medo64/Cananka/Hardware/Board/Cananka [D].md

### Cananka USB ###

Board size: 105.8 x 26.0 mm ~ 4.3 sqin
Panel size: 29.5 x 20.3 mm ~ 1.0 sqin (2x)

#### Input ####

Voltage: 5 V ±10%
Current: 100 mA

#### Parts ####

|  # | Part | RefDes  | Preferred Part Number | Alternate Part Number |
|---:|---|---|---|---|
|  2 | C 22pF NP0 16V (0805) | C1 C2 | 399-8036-1-ND | |
|  4 | C 100nF X7R 16V (0805) | C3-C6 | 478-5311-1-ND | |
|  1 | C 330nF X7R 16V (0805) | C7 | 732-7669-1-ND | |
|  3 | C 10uF X5R 16V (0805) | C8-C10  | 1276-1096-1-ND | |
|  1 | D TVS 150W Zenner CAN (SOT23-3) | D1 | 497-13262-1-ND | 568-4032-1-ND |
|  1 | DS LED RGB CA (1204) | DS1 | 160-2234-1-ND | |
|  5 | DS LED (0805) | DS2-DS6 | 475-1415-1-ND | |
|  1 | J USB B, horizontal | J1 | ED2982-ND | |
|  1 | J MC 1,5/ 4-G-3,81 | J2 | ED2810-ND | 277-1208-ND |
|  1 | L Ferrite 40Ohm (0805) | L1 | 445-2201-1-ND | |
|  4 | R 120 0.125W (0805) | R1-R4 | 311-120CRCT-ND | |
|  4 | R 330 0.125W (0805) | R5-R8 | RMCF0805FT330RCT-ND | CR0805-FX-3300GLFCT-ND |
|  7 | R 1K 0.125W (0805) | R9-R15  | RMCF0805FT1K00CT-ND | 311-1.00KCRCT-ND |
|  1 | U MCP2221A (TSSOP-14) | U1 | MCP2221A-I/ST-ND | |
|  1 | U PIC18F25K80 (SSOP-28) | U2 | PIC18F25K80-I/SS-ND | |
|  1 | U ISO1050 (SOP-8) | U3 | 296-24818-1-ND | |
|  1 | VR DC-DC 5V->5V 1W (SIP-4) | VR1 | 945-1655-5-ND | |
|  1 | Y Crystal 12MHz 50ppm 20pF | Y1 | 887-2011-ND | 887-1238-ND |
|  1 | H Enclosure 1593DBK | | HM861-ND | |
|  4 | H PCB Screw Self-tapping M3 6mm (#4 1/4") | | 36-9191-3-ND | SR6004-ND |
|  2 | P MC 1,5/ 4-ST-3,81 | | ED2877-ND | 277-1163-ND |

#### UART Configuration ####

In order to configure the device, one has to use MCP2221 Utility application
(download from Microchip). Device works with factory configuration but the
following changes are suggested:

    * Descriptor: Cananka
    * Manufacturer: Josip Medved
    * Enumerate with serial number: Yes

All other settings should remain default.
