medo64/Cananka/USB/Hardware-mini/Board/Cananka USBmini [D].md

### Cananka USB/mini ###

Board size: 54.0 x 16.5 mm ~ 1.4 sqin

#### Input ####

Voltage: 5 V ±10%
Current: 500 mA

#### Parts ####

|  # | Part | RefDes  | Preferred Part Number | Alternate Part Number |
|---:|---|---|---|---|
|  3 | C 100nF X7R 16V (0805) | C1-C3 | 478-5311-1-ND | |
|  1 | C 330nF X7R 16V (0805) | C4 | 732-7669-1-ND | |
|  2 | C 10uF X5R 16V (0805) | C5-C6 | 1276-1096-1-ND | |
|  1 | D Shottky 30V LowVf {SDM100K30L} (SOD323) | D1 | SDM100K30LDIDKR-ND | BAS3010A03WE6327HTSA1CT-ND |
|  6 | DS LED (0805) | DS1-DS6 | 475-1415-1-ND | |
|  1 | J MC 1,5/ 4-G-3,81 | J2 | ED2810-ND | 277-1208-ND |
|  1 | L Ferrite 40Ohm (0805) | L1 | 445-2201-1-ND | |
|  1 | P USB A, plug, horizontal | P1 | WM3983CT-ND | WM17118-ND |
|  2 | Q P-MOSFET 20V LowVgs {DMG2305UX} | Q1 Q2 | DMG2305UX-13DICT-ND | |
|  4 | R 120 0.125W (0805) | R1-R4 | 311-120CRCT-ND | |
|  3 | R 330 0.125W (0805) | R5-R7 | RMCF0805FT330RCT-ND | CR0805-FX-3300GLFCT-ND |
|  6 | R 1K 0.125W (0805) | R8-R13  | RMCF0805FT1K00CT-ND | 311-1.00KCRCT-ND |
|  1 | U MCP2221A (TSSOP-14) | U1 | MCP2221A-I/ST-ND | |
|  1 | U PIC18F25K80 (SSOP-28) | U2 | PIC18F25K80-I/SS-ND | |
|  1 | U MCP2561 (SOIC-8) | U3 | MCP2561-E/SN-ND | 568-10289-1-ND |
|  1 | P MC 1,5/ 4-ST-3,81 | | ED2877-ND | 277-1163-ND |

1/2" heat-shrink tubing, 50mm

WARNING: This is a non-isolated board - beware of ground loops and all the fun
that can happen with different ground potentials.

#### UART Configuration ####

In order to configure the device, one has to use MCP2221 Utility application
(download from Microchip). In configuration, one MUST perform the following
changes:

    * GP1: 1 (CLK_OUT)

The following changes are suggested:

    * Required Current: 500 mA
    * Descriptor: Cananka
    * Manufacturer: Josip Medved
    * Enumerate with serial number: Yes

All other settings should remain default.
