medo64/Cananka/Hardware/Board/Cananka [D] Configuration.png

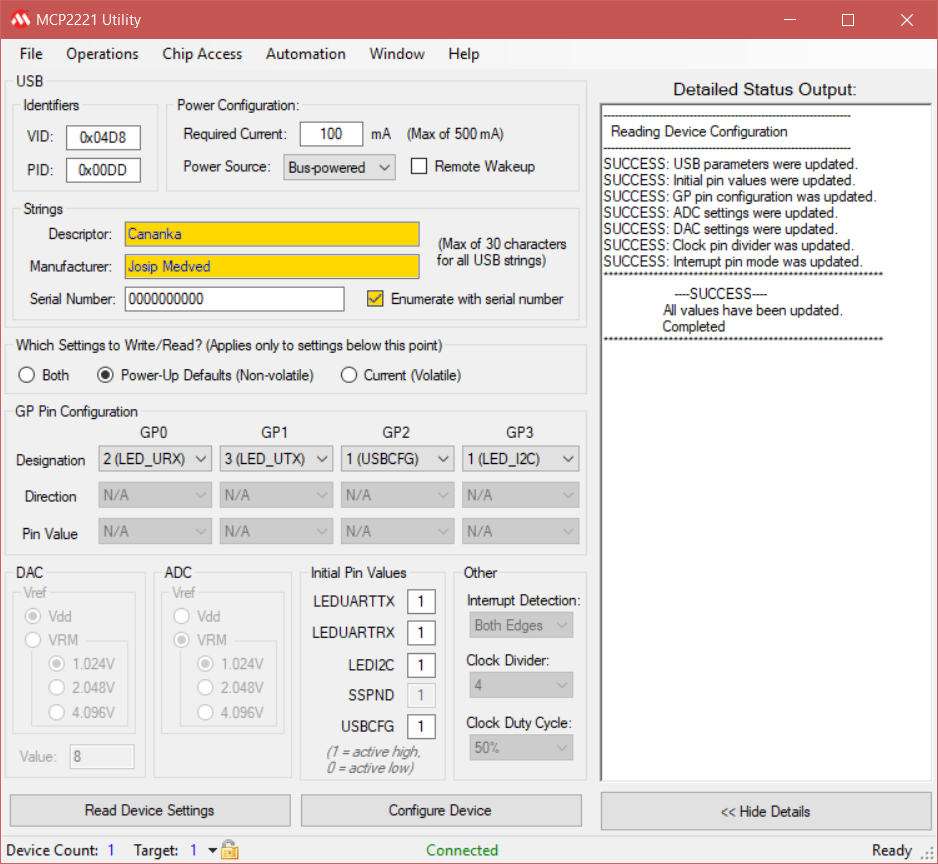
Hardware/Board/Cananka [D] Configuration.png
