medo64/Cananka/SCHEMATICS-RJ45.pdf

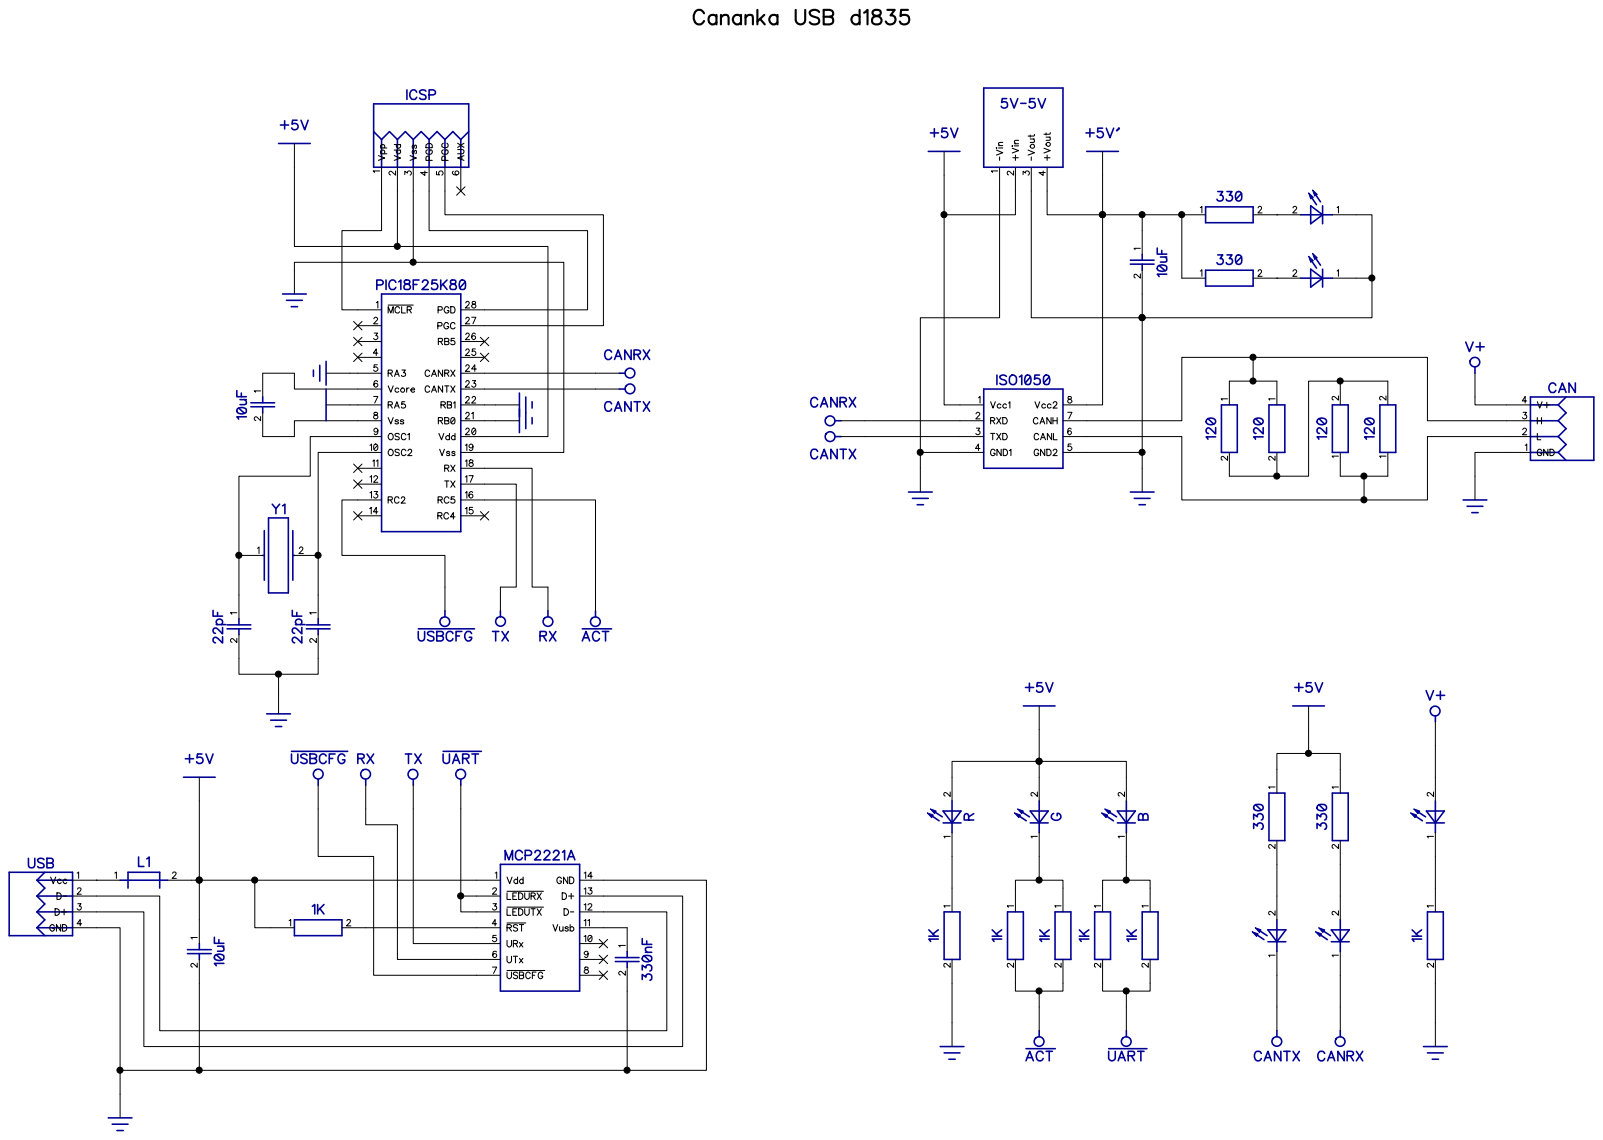
[picture p2: page 1]
