medo64/Cananka/(list of files, drawings)

Other design files:
Hardware/Board/Cananka [D] Panel Back.dip
Hardware/Board/Cananka [D] Panel Front.dip
Hardware/Board/Cananka [D].dch
Hardware/Board/Cananka [D].dip
Hardware/Board/RJ45/Cananka RJ45 [D] Panel Back.dip
Hardware/Board/RJ45/Cananka RJ45 [D] Panel Front.dip
Hardware/Board/RJ45/Cananka RJ45 [D].dip
