medo64/Cananka/(commit log)

2016-05-09 Initial version.
    [Cananka [A].dip]
2016-05-13 Corrected components.
    [Cananka [A].dip]
2016-05-15 Updated board to fit official case.
    [Cananka [A].dip, Cananka [B].dip]
2016-05-15 Refactoring LEDs and adding test points.
    [Cananka [B].dip]
2016-05-15 Moved CAN connector descriptions.
    [Cananka [B].dip]
2016-05-15 Added forgotten RESET pullup.
    [Cananka [B].dip]
2016-05-15 Added silk screen for SPI.
    [Cananka [B].dip]
2016-05-15 Moved fuse to top layer.
    [Cananka [B].dip]
2016-05-16 Adjusted silk screen.
    [Cananka [B].dip]
2016-05-26 Increasing hole size for 12V->5V VR.
    [Cananka [B].dip]
2016-05-26 Swapped VR2 pinout to correct one.
    [Cananka [B].dip, Cananka [C].dip]
2016-05-26 Refactoring write-protect to use positive logic.
    [Cananka [C].dip]
2016-05-26 Refactoring LED placement.
    [Cananka [C].dip]
2016-05-27 Refactoring layout.
    [Cananka [C].dip]
2016-05-27 Moving Ext LED source to after fuse.
    [Cananka [C].dip]
2016-05-27 Refactoring flood-fill.
    [Cananka [C].dip]
2016-06-13 Updating silkscreen and instructions.
    [Cananka [C].dip]
2016-06-13 Fixed bug with remote on/off.
    [Cananka [C].dip, Cananka [D].dip]
2016-08-22 Moving WP wires a bit away.
    [Cananka [D].dip]
2017-05-28 Changed bear icon.
    [Cananka [D].dip]
2017-06-03 Adjusted icon.
    [Cananka [D].dip]
2018-07-08 Moving HAT to a separate directory.
    [Cananka HAT [D].dip, Cananka [D].dip]
2018-07-09 Added CanStick to USB, USBmini, and USB-RJ45 directories.
    [CanBusSpeed.xlsx, Cananka USB [B] Panel Back.dip, Cananka USB [B] Panel Front.dip, Cananka USB [B].dip, Cananka USB-RJ45 [B] Panel Back.dip, Cananka USB-RJ45 [B] Panel Front.dip, Cananka USB-RJ45 [B].dip, Cananka USBmini [C].dip]
2018-07-14 Added termination control and status LED.
    [Cananka USB [B] Panel Back.dip, Cananka USB [B].dip, Cananka USB [C] Panel Back.dip, Cananka USB [C] Panel Front.dip, Cananka USB [C].dip, Cananka USB-RJ45 [B] Panel Back.dip, Cananka USB-RJ45 [B].dip, Cananka USB-RJ45 [C] Panel Back.dip]
2018-08-16 Added screw description.
2018-08-16 Update ICSP connector to be more frendly to pogo pins.
    [Cananka USB [C].dip, Cananka USB-RJ45 [C].dip, Cananka USBmini [C].dip]
2018-08-16 Added RGB LED anode marking.
    [Cananka USB [C].dip, Cananka USB-RJ45 [C].dip]
2018-08-17 Adding current limiting resistor to optocoupler.
    [Cananka USB [C].dip, Cananka USB-RJ45 [C].dip]
2018-08-17 Removing resistor array to minimize component count.
    [Cananka USB [C].dip, Cananka USB-RJ45 [C].dip]
2018-08-17 Changed MOSFET to a low Vgs one.
    [Cananka USB [C].dip, Cananka USBmini [C].dip]
2018-08-17 Swaping 10K resistor for 1K to reduce component count at the cost of current.
    [Cananka USB [C].dip, Cananka USB-RJ45 [C].dip]
2018-08-17 Removed controllable termination as it downgrades CAN bus resiliency to transients.
    [Cananka USB [C].dip, Cananka USB-RJ45 [C].dip]
2018-08-17 Updated USBmini to use MCP2221A instead of MCP2221.
    [Cananka USBmini [C].dip]
2018-08-17 Swapping FT232RL for MCP2221A.
    [Cananka USB [C].dip, Cananka USB-RJ45 [C].dip]
2018-08-17 Minor refactorings.
    [Cananka USBmini [C].dip]
2018-08-17 Replaced diode for an equivalent one.
    [Cananka USBmini [C].dip]
2018-08-17 Added UART configuration description.
2018-08-17 Refactoring board to lower component count.
    [Cananka USBmini [C].dip]
2018-08-17 Sorting out components for easier availability.
    [Cananka USB [C].dip, Cananka USB-RJ45 [C].dip, Cananka USBmini [C].dip]
2018-08-18 Expanded choice of TVS diode.
    [Cananka USB [C].dip, Cananka USB-RJ45 [C].dip]
2018-08-18 Clock isn't sent out on non-FTDI devices.
    [Cananka USB [C].dip, Cananka USB-RJ45 [C].dip]
2018-08-21 TVS diodes a bit closer to the pins.
    [Cananka USB [C].dip, Cananka USB-RJ45 [C].dip]
2018-08-21 Swapped resistor and LED (Active) so all LEDs are pulled the same way.
    [Cananka USBmini [C].dip]
2018-08-21 Added USBmini schematics.
    [Cananka USBmini [C].dch]
2018-08-21 Rotating LED to point the same way as the other.
    [Cananka USB [C].dip, Cananka USB-RJ45 [C].dip]
2018-08-22 Added schematics for USB.
    [Cananka USB [C].dch, Cananka USB [C].dip, Cananka USB-RJ45 [C].dip, Cananka USBmini [C].dch]
2018-08-22 Fixing copper pour on USB/mini.
    [Cananka USBmini [C].dip]
2018-08-25 Corrected revision file naming.
    [Cananka USB [C].dip, Cananka USB [D] Panel Back.dip, Cananka USB [D] Panel Front.dip, Cananka USB [D].dch, Cananka USB [D].dip, Cananka USB-RJ45 [C].dip, Cananka USB-RJ45 [D] Panel Back.dip, Cananka USB-RJ45 [D] Panel Front.dip]
2018-08-25 Added extra details for pin configuration.
2018-08-27 Changed USBmini connector to a horizontal one.
    [Cananka USBmini [D].dip]
2018-08-27 Reorganizing silk screen a bit.
    [Cananka USBmini [D].dip]
2018-09-02 Placing another resistor on blue LED channel.
    [Cananka USB [D].dch, Cananka USB [D].dip, Cananka USB-RJ45 [D].dip]
2018-09-03 Refactoring device versioning.
    [Cananka USB [D].dip, Cananka USB-RJ45 [D].dip, Cananka USBmini [D].dip]
2018-09-03 Connecting USBCFG to RC2.
    [Cananka USB [D].dch, Cananka USB [D].dip, Cananka USB-RJ45 [D].dip, Cananka USBmini [D].dch, Cananka USBmini [D].dip]
2018-09-03 Load is stopped once CAN bus is closed.
2018-09-03 Refactoring versioning.
    [Cananka USB [D].dip, Cananka USB-RJ45 [D].dip]
2018-09-03 Expanding versioning a bit.
    [Cananka USBmini [D].dip]
2018-09-03 Updated schematics.
2018-09-04 Added metric screw DigiKey code.
2018-09-16 Moved ground a bit.
    [Cananka USB [D].dip, Cananka USB-RJ45 [D].dip]
2018-09-17 Corrected capacitor count.
2018-09-17 Swapped 22pF capacitors to 0805.
    [Cananka USB [D].dip, Cananka USB-RJ45 [D].dip]
2018-09-18 Renamed UartBuffer to CommandBuffer.
2018-09-18 Reworked UART receive to use interrupts.
2018-09-21 Removed support for MCP2562 from USB/mini.
    [Cananka USBmini [D].dip]
2018-09-21 Made USB/mini board smaller to match CAN connector size.
    [Cananka USBmini [D].dip]
2018-09-21 Reorientating LEDs.
    [Cananka USBmini [D].dip]
2018-09-21 Merged schematics update.
    [Cananka USBmini [D].dch]
2018-10-29 Updated LED count.
2018-10-29 Reorganizing directory structure a bit.
    [Cananka USB-RJ45 [D] Panel Back.dip, Cananka USB-RJ45 [D] Panel Front.dip, Cananka USB-RJ45 [D].dip, Cananka USBmini [D].dch, Cananka USBmini [D].dip]
2018-10-29 Moving version silkscreen to top.
    [Cananka USB [D].dip, Cananka USB-RJ45 [D].dip]
2018-10-29 Updated version silkscreen.
    [Cananka USBmini [D].dip]
2018-10-29 Option to save CAN bus settings for the next boot.
2021-10-03 Added new board sized as framework module (not tested)
    [Cananka USBframework [D] Tongue.dip, Cananka USBframework [D].dip]
2021-10-03 Minor refactoring
    [Cananka USBframework [D].dip]
2021-10-09 Separate pinout for Cananka/framework
    [Cananka USBframework [D].dip]
2021-11-23 Splintered HAT into a separate repository
    [CanBusSpeed.xlsx, Cananka Framework [D] Tongue.dip, Cananka Framework [D].dip, Cananka HAT [D].dip, Cananka Mini [D].dch, Cananka Mini [D].dip, Cananka RJ45 [D] Panel Back.dip, Cananka RJ45 [D] Panel Front.dip]
2021-12-06 Adjusted to also fit Bud HP-3653-B
    [Cananka [D].dip]
2024-06-04 Moved firmware to a separate repository
    [CanBusSpeed.xlsx]
2024-06-04 Removing framework files
    [Cananka Framework [D] Tongue.dip, Cananka Framework [D].dip]
2024-06-04 Removing 'mini' files
    [Cananka Mini [D].dch, Cananka Mini [D].dip]
